TallesSantosCUBoulder/ArduinoRoboticHandControl/KiCadPCBFiles/bkp/ForwardCEWBPCBDesign_EXAMPLE/ForwardCEWBPCBDesign.step

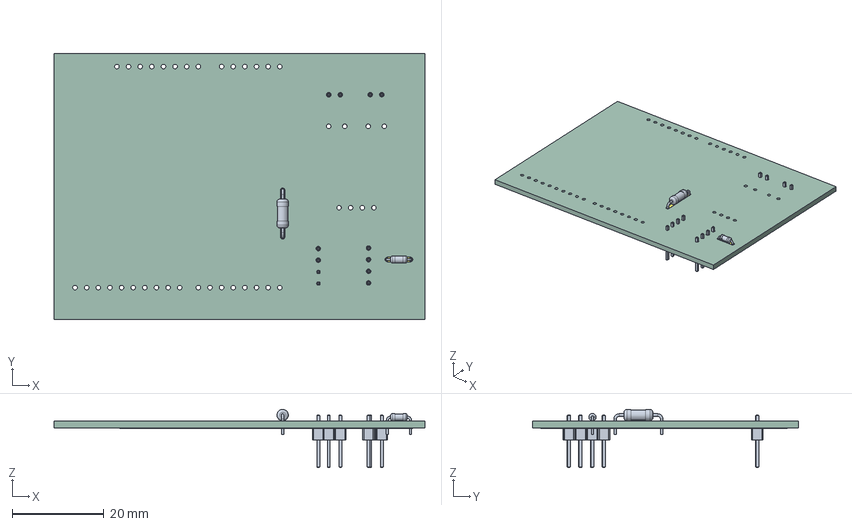
[picture p1: CAD file, 2026-04-28]
KiCadPCBFiles/bkp/ForwardCEWBPCBDesign_EXAMPLE/ForwardCEWBPCBDesign.step
81.0 x 58.2 x 12.7 mm
R_Axial_DIN0204_L3.6mm_D1.6mm_P5.08mm_Horizontal
R_Axial_DIN0207_L6.3mm_D2.5mm_P10.16mm_Horizontal
PinHeader_1x04_P2.54mm_Vertical x 2
PinHeader_1x02_P2.54mm_Vertical x 2
ForwardCEWBPCBDesign_copper
ForwardCEWBPCBDesign_PCB
