TallesSantosCUBoulder/ArduinoRoboticHandControl/STLFiles/Arm.stl

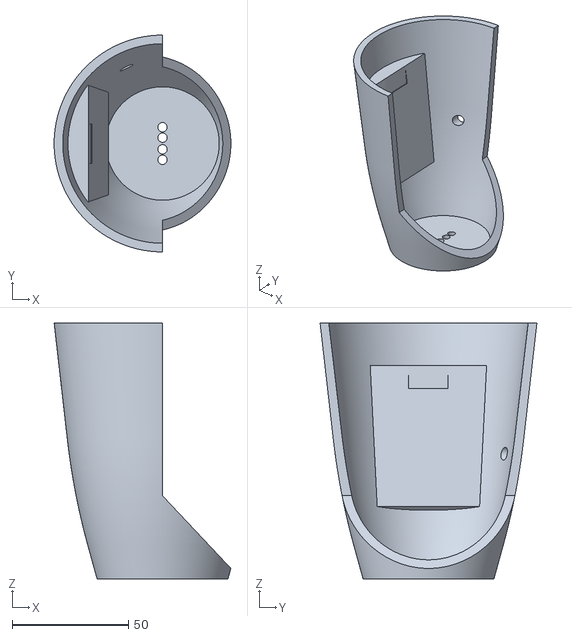
[picture p2: CAD file, 2026-05-08]
STLFiles/Arm.stl
76.0 x 93.2 x 110.0
