TallesSantosCUBoulder/ArduinoRoboticHandControl/STLFiles/HandRIGHT.stl

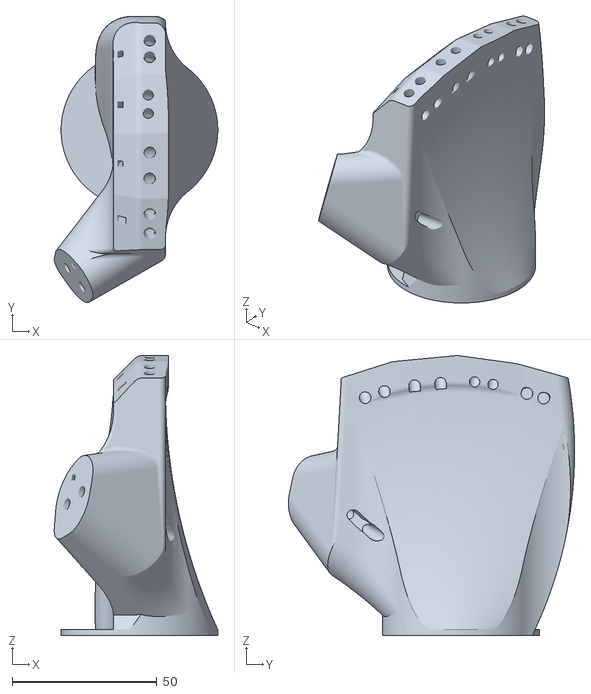
[picture p3: CAD file, 2026-05-08]
STLFiles/HandRIGHT.stl
56.5 x 98.9 x 96.8
