TallesSantosCUBoulder/ArduinoRoboticHandControl/STLFiles/ArmStand.stl

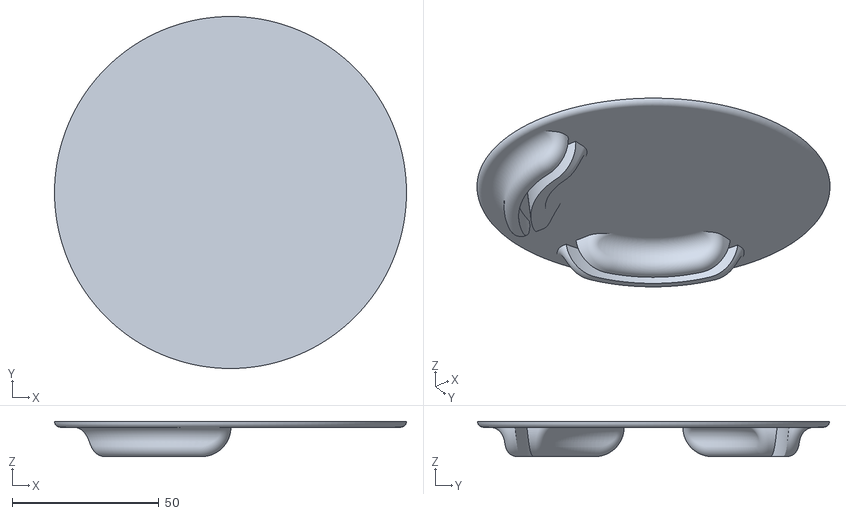
[picture p4: CAD file, 2026-05-08]
STLFiles/ArmStand.stl
120.0 x 120.0 x 12.0
