TallesSantosCUBoulder/ArduinoRoboticHandControl/(list of files, cad)

Other CAD files:
STLFiles/FingersALL.stl
STL_Files/FingersALL.stl
