TallesSantosCUBoulder/ArduinoRoboticHandControl/KiCadPCBFiles/PCB_v1/ForwardCEWBPCBDesign.kicad_pcb

## KiCad design KiCadPCBFiles/PCB_v1/ForwardCEWBPCBDesign.kicad_pcb (2026-04-28)

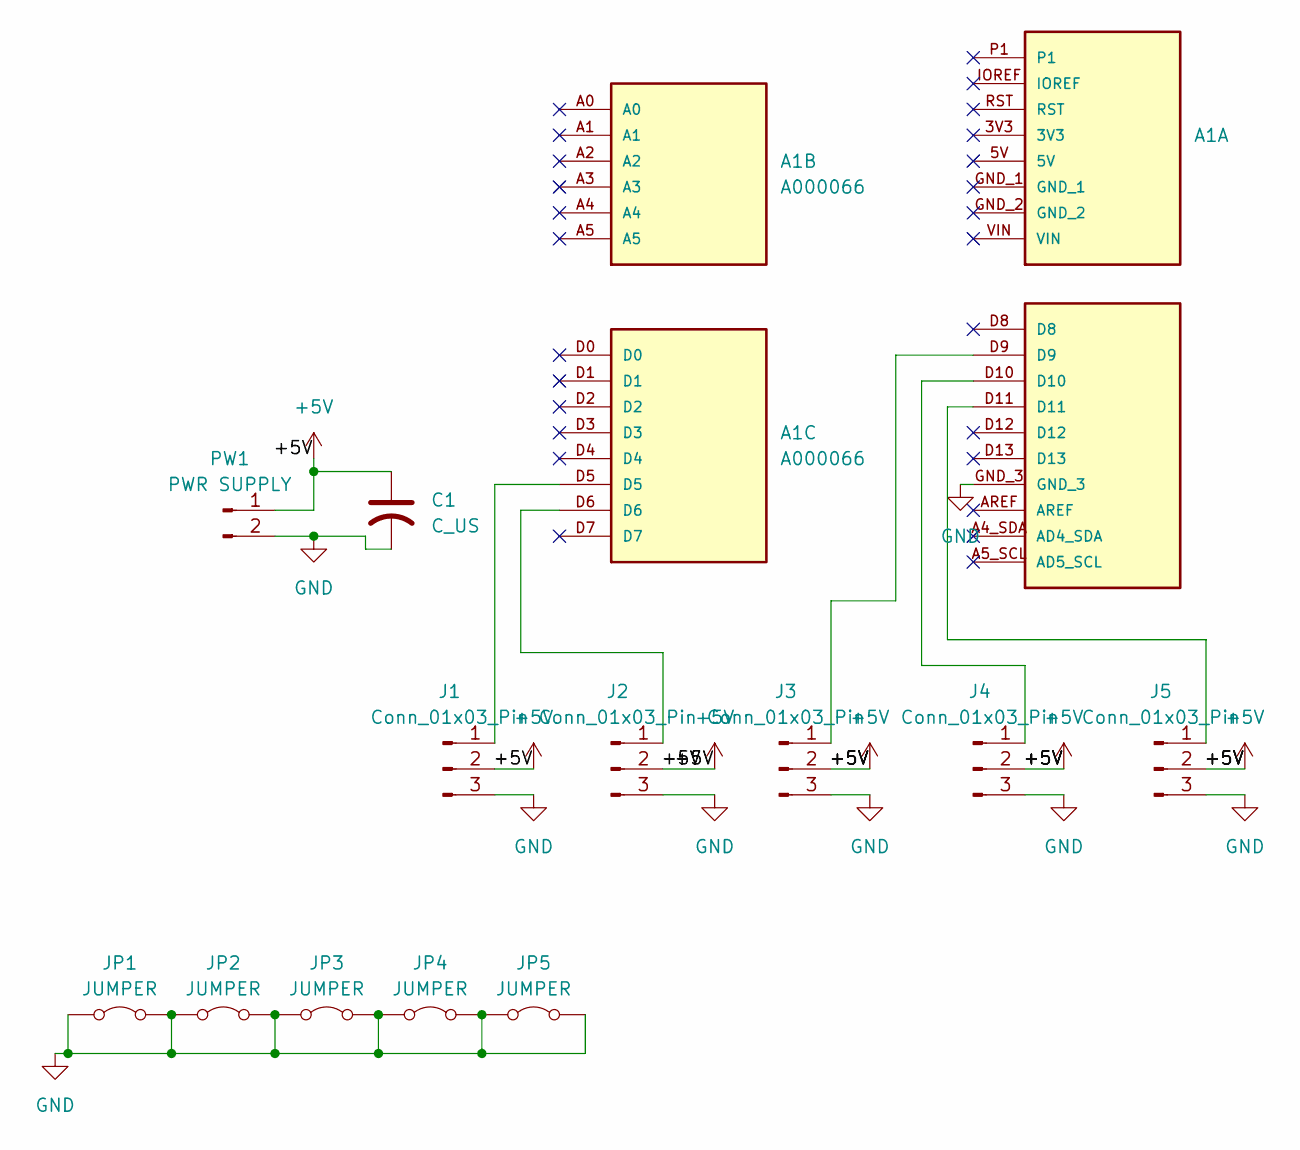
[picture p5: schematic ForwardCEWBPCBDesign.kicad_sch]

Parts:
A1: A000066; ARDUINO_A000066
C1: C_US; CP_Radial_D12.5mm_P5.00mm
J1, J2, J3, J4, J5: Conn_01x03_Pin; PinHeader_1x03_P2.54mm_Vertical
JP1, JP2, JP3, JP4, JP5: JUMPER; R_Axial_DIN0207_L6.3mm_D2.5mm_P10.16mm_Horizontal
PW1: PWR SUPPLY; PinHeader_1x02_P2.54mm_Vertical

Connections:
+5V: C1.1, J1.2, J2.2, J3.2, J4.2, J5.2, PW1.1
GND: A1.GND_3, C1.2, J1.3, J2.3, J3.3, J4.3, J5.3, JP1.1 (A), JP1.2 (B), JP2.1 (A), JP2.2 (B), JP3.1 (A), JP3.2 (B), JP4.1 (A), JP4.2 (B), JP5.1 (A), JP5.2 (B), PW1.2
unnamed: A1.D5, J1.1
unnamed: A1.D6, J2.1
unnamed: A1.D9, J3.1
unnamed: A1.D10, J4.1
unnamed: A1.D11, J5.1

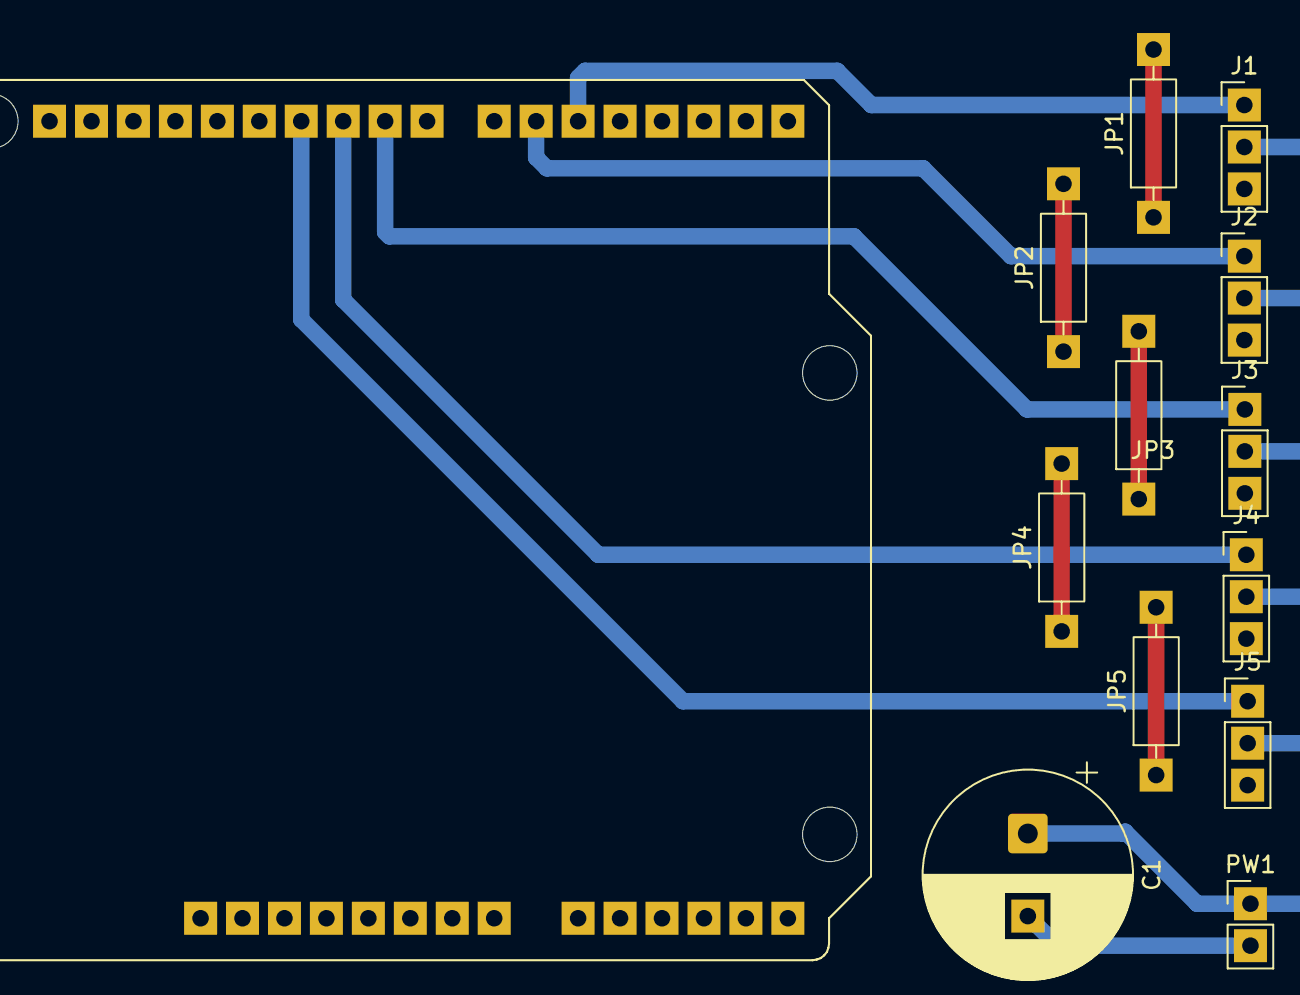
[picture p6: board KiCadPCBFiles/PCB_v1/ForwardCEWBPCBDesign.kicad_pcb from above]

Board: 2 copper layers, 13 parts (0 on the bottom side), 7 nets.
