TallesSantosCUBoulder/ArduinoRoboticHandControl/KiCadPCBFiles/bkp/ForwardCEWBPCBDesign_EXAMPLE/ForwardCEWBPCBDesign.kicad_pcb

## KiCad design KiCadPCBFiles/bkp/ForwardCEWBPCBDesign_EXAMPLE/ForwardCEWBPCBDesign.kicad_pcb (2026-04-28)

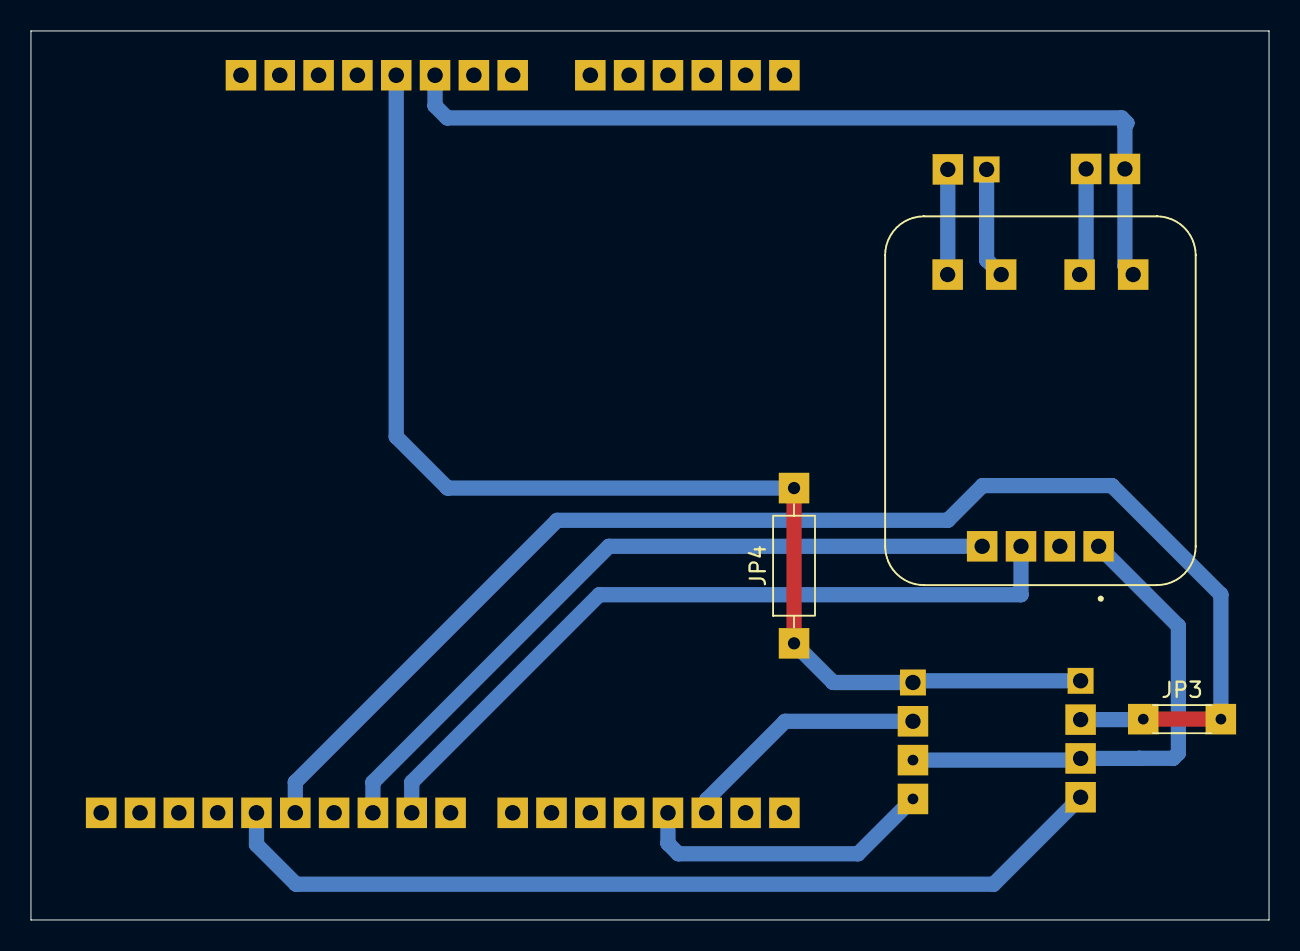
[picture p7: board KiCadPCBFiles/bkp/ForwardCEWBPCBDesign_EXAMPLE/ForwardCEWBPCBDesign.k… from above]

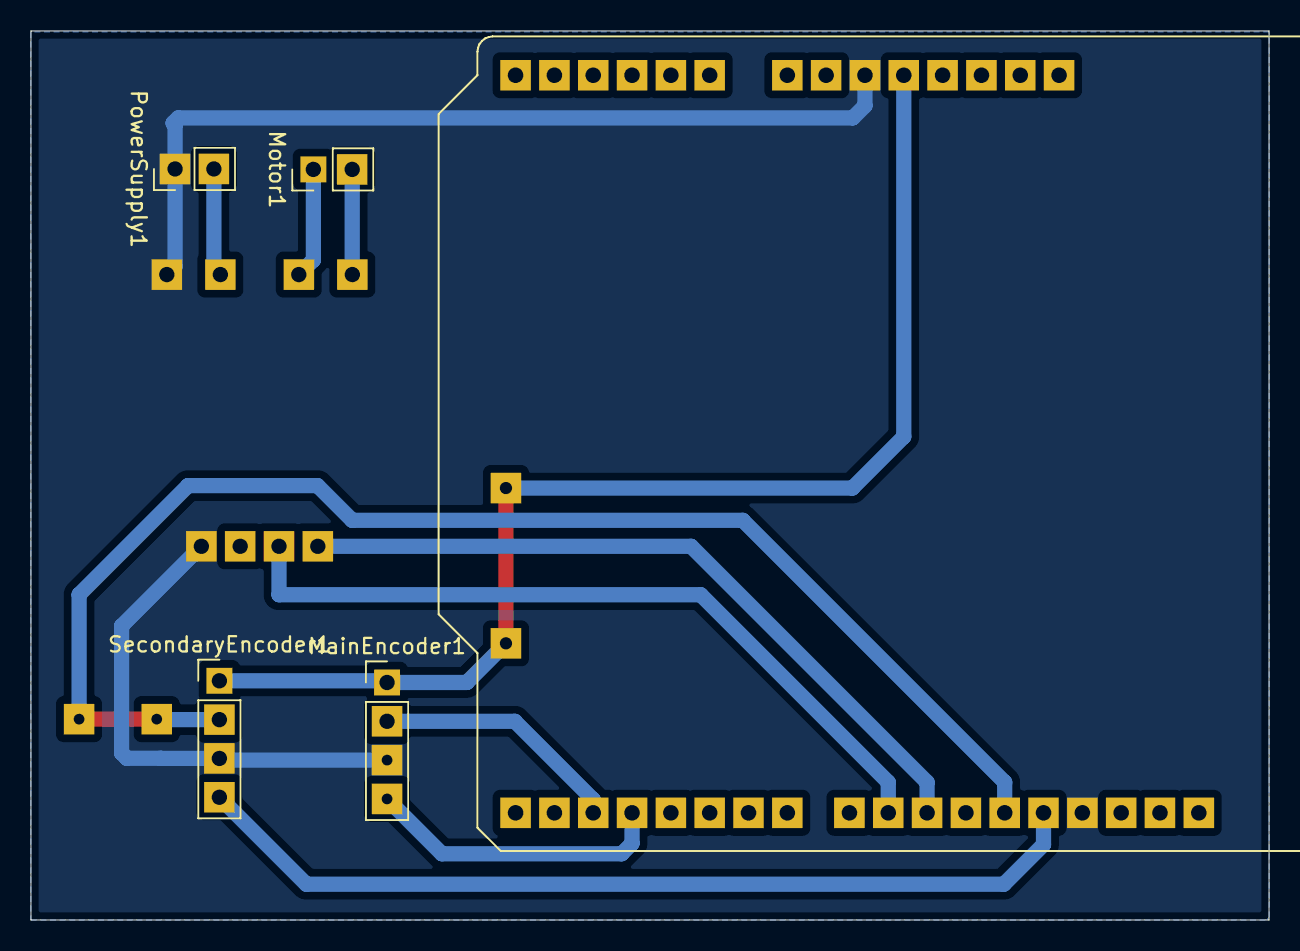
[picture p8: board KiCadPCBFiles/bkp/ForwardCEWBPCBDesign_EXAMPLE/ForwardCEWBPCBDesign.k… from below]

Board: 2 copper layers, 81.0 x 58.2 mm, 8 parts (5 on the bottom side), 11 nets.

Parts:
A1: A000066; ARDUINO_A000066
DRV1: DRV8871_manual
JP3: Jumper_2_Bridged; R_Axial_DIN0204_L3.6mm_D1.6mm_P5.08mm_Horizontal
JP4: Jumper_2_Bridged; R_Axial_DIN0207_L6.3mm_D2.5mm_P10.16mm_Horizontal
MainEncoder1: Conn_01x04_Pin; PinHeader_1x04_P2.54mm_Vertical
Motor1: Conn_01x02_Pin; PinHeader_1x02_P2.54mm_Vertical
PowerSupply1: Conn_01x02_Pin; PinHeader_1x02_P2.54mm_Vertical
SecondaryEncoder1: Conn_01x04_Pin; PinHeader_1x04_P2.54mm_Vertical

Connections:
+5C: A1.5V, JP4.1 (A), JP4.2 (B), MainEncoder1.1, SecondaryEncoder1.1
/D12: A1.D12, JP3.1 (A), JP3.2 (B), SecondaryEncoder1.2
/D13: A1.D13, SecondaryEncoder1.4
/In1: A1.D9, DRV1.2 (In1)
/In2: A1.D10, DRV1.1 (In2)
GND: A1.GND_2, A1.GND_3, DRV1.4 (GND), DRV1.5 (PW_-), MainEncoder1.3, PowerSupply1.1, SecondaryEncoder1.3
unnamed: DRV1.7 (Out_1), Motor1.1
unnamed: DRV1.8 (Out_2), Motor1.2
unnamed: DRV1.6 (PW_+), PowerSupply1.2
unnamed: A1.D2, MainEncoder1.2
unnamed: A1.D3, MainEncoder1.4
