TallesSantosCUBoulder/ArduinoRoboticHandControl/(commit log)

2026-04-28 PCB example.
2026-04-28 PCB V1.
    [ForwardCEWBPCBDesign.kicad_pcb, ForwardCEWBPCBDesign.kicad_sch, ForwardCEWBPCBDesign.step]
